c-daly/skala/firmware/opencr_reflex/README.md

# opencr_reflex

Reflex layer for prototype 0, running on the OpenCR 1.0 (Arduino-compatible, Dynamixel TTL bus, onboard IMU).

Responsibilities: arm pitch position limits, drive velocity, servo current trips, IMU tip-over cutoff,
500 ms watchdog on the serial link to the Pi, framed serial protocol. Not yet started.
