c-daly/skala/docs/concept/track_robot_concept.png

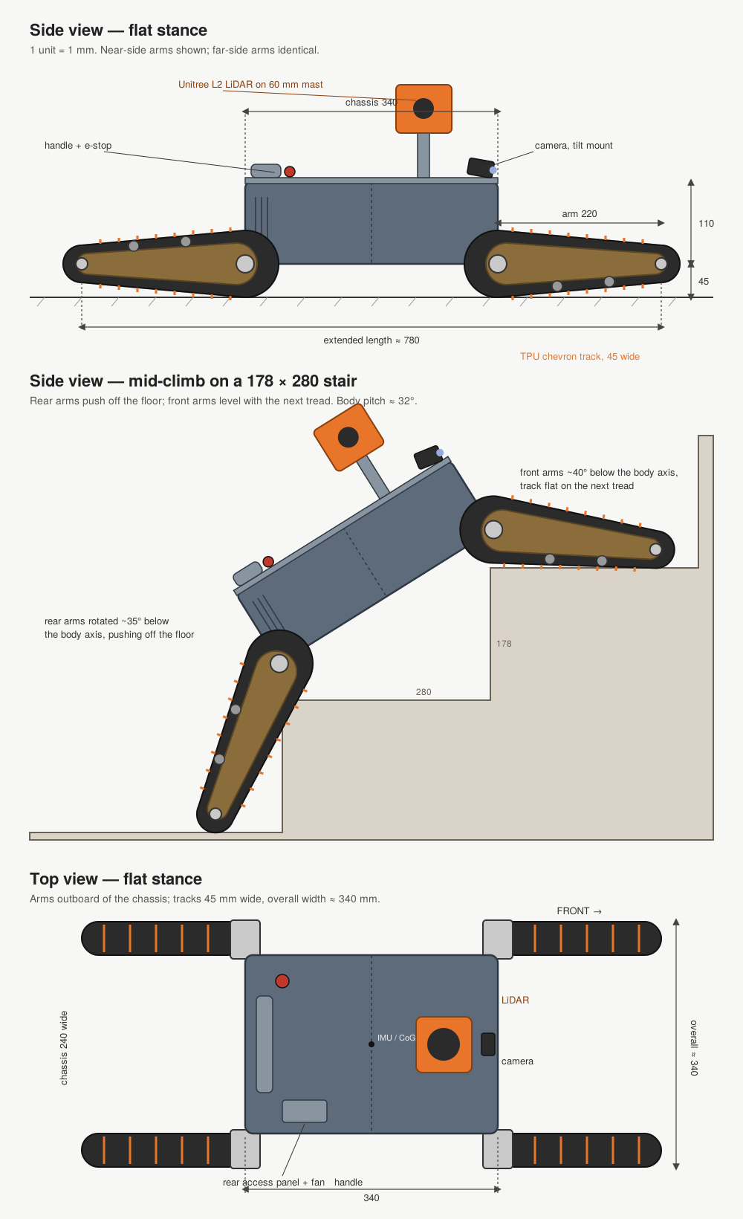
docs/concept/track_robot_concept.png
