c-daly/skala/cad/out/step/assembly_p0_4arm_pitch30.step

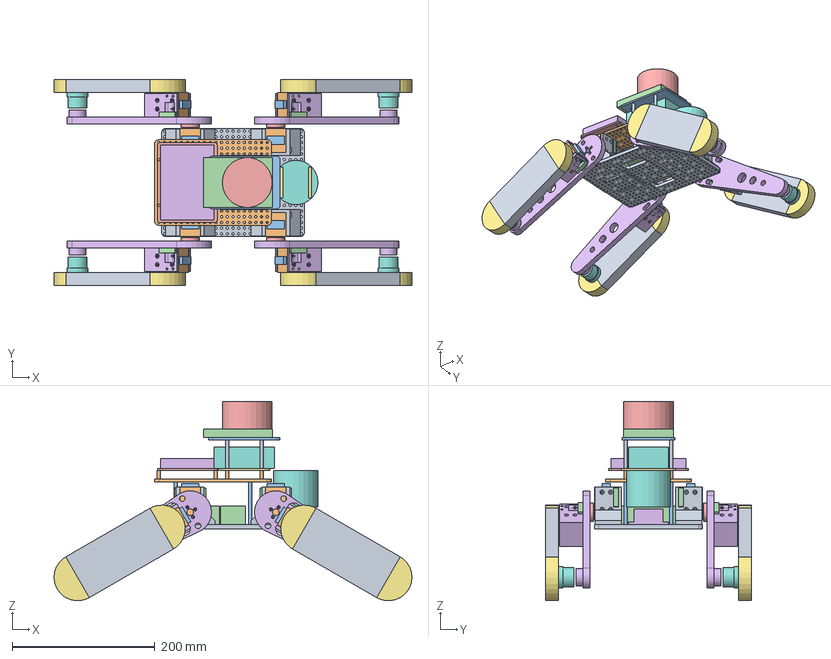
[picture p2: CAD file, 2026-10-28]
cad/out/step/assembly_p0_4arm_pitch30.step
501.7 x 288.4 x 279.5 mm
chassis_p0
deck_p0
opencr_adapter_p0
pi_adapter_p0
lidar_adapter_p0
pan_base_p0
tilt_yoke_p0
pitch_mount_p0 x 4
pivot_spacer_p0 x 4
arm_p0 x 4
tip_hub_p0 x 4
