c-daly/skala/cad/out/step/assembly_p0_pitch30.step

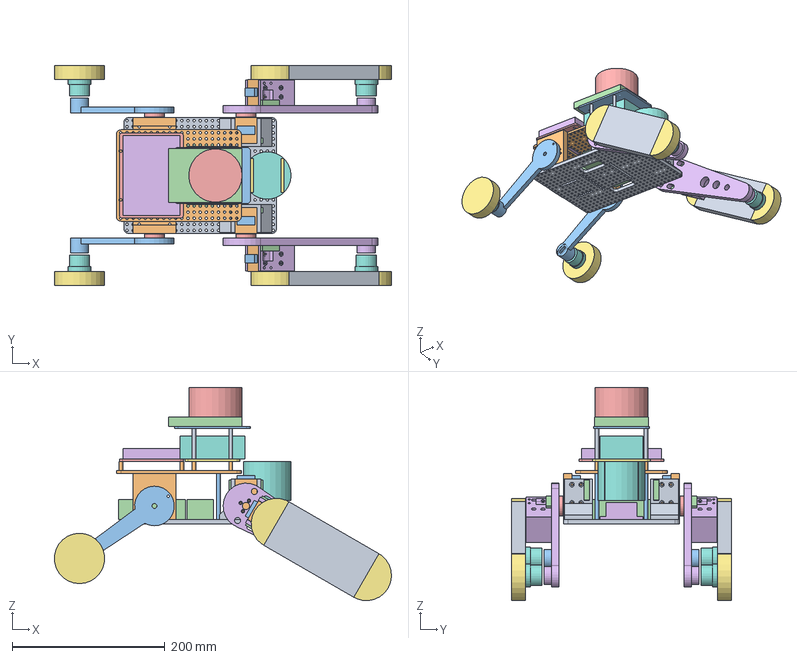
[picture p3: CAD file, 2026-10-28]
cad/out/step/assembly_p0_pitch30.step
442.0 x 288.4 x 279.5 mm
chassis_p0
deck_p0
opencr_adapter_p0
pi_adapter_p0
lidar_adapter_p0
pan_base_p0
tilt_yoke_p0
pitch_mount_p0 x 2
pivot_spacer_p0 x 4
arm_p0 x 2
tip_hub_p0 x 4
skid_bracket_p0 x 2
skid_arm_p0 x 2
