c-daly/skala/cad/out/step/assembly_p0_pitch0.step

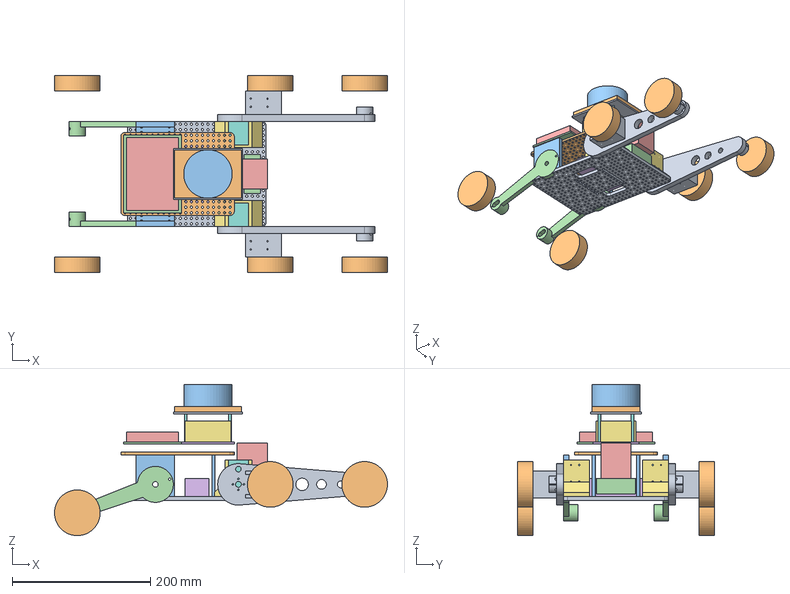
[picture p4: CAD file, 2026-10-28]
cad/out/step/assembly_p0_pitch0.step
481.0 x 284.0 x 218.5 mm
chassis_p0
deck_p0
pitch_mount_p0 x 2
arm_p0 x 2
skid_bracket_p0 x 2
skid_arm_p0 x 2
