c-daly/skala/cad/out/step/assembly_p0_4arm_pitch0.step

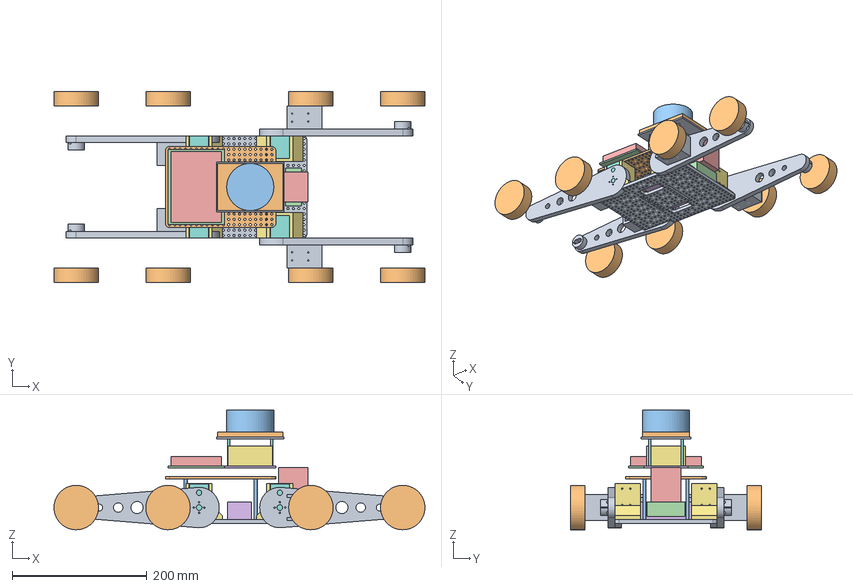
[picture p5: CAD file, 2026-10-28]
cad/out/step/assembly_p0_4arm_pitch0.step
550.6 x 284.0 x 177.4 mm
chassis_p0
deck_p0
pitch_mount_p0 x 4
arm_p0 x 4
