c-daly/skala/cad/out/step/assembly_p0_pitch45.step

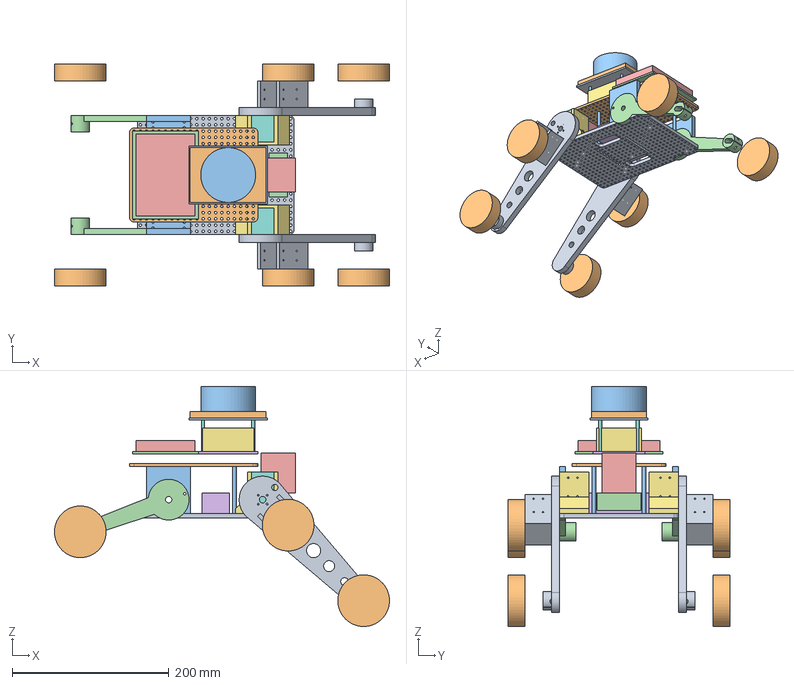
[picture p6: CAD file, 2026-10-28]
cad/out/step/assembly_p0_pitch45.step
427.6 x 284.0 x 306.4 mm
chassis_p0
deck_p0
pitch_mount_p0 x 2
arm_p0 x 2
skid_bracket_p0 x 2
skid_arm_p0 x 2
