c-daly/skala/cad/out/step/skid_bracket_p0_L.step

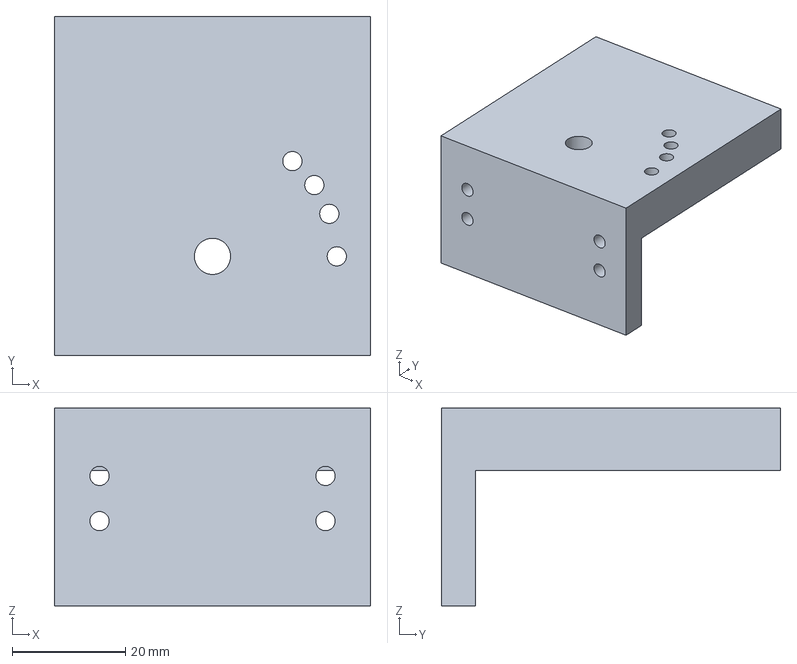
[picture p7: CAD file, 2026-10-28]
cad/out/step/skid_bracket_p0_L.step
56.0 x 60.0 x 35.0 mm
