c-daly/skala/cad/out/step/camera_cradle_p0.step

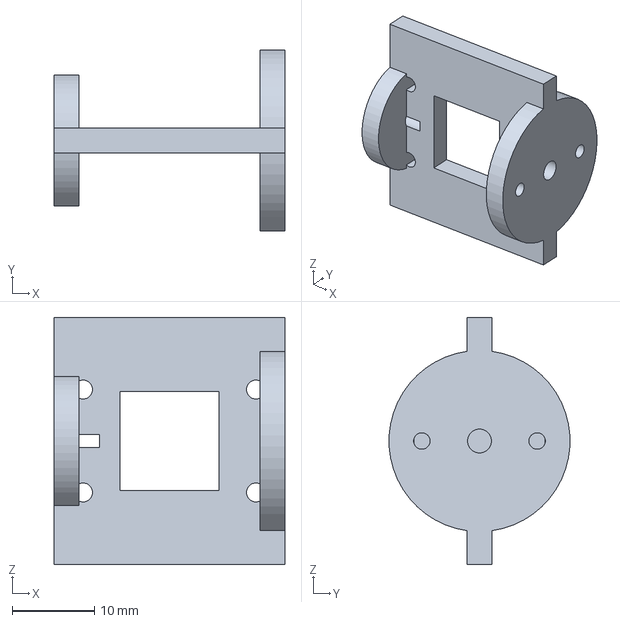
[picture p8: CAD file, 2026-10-28]
cad/out/step/camera_cradle_p0.step
28.0 x 22.0 x 30.0 mm
