c-daly/skala/cad/out/step/arm_p0.step

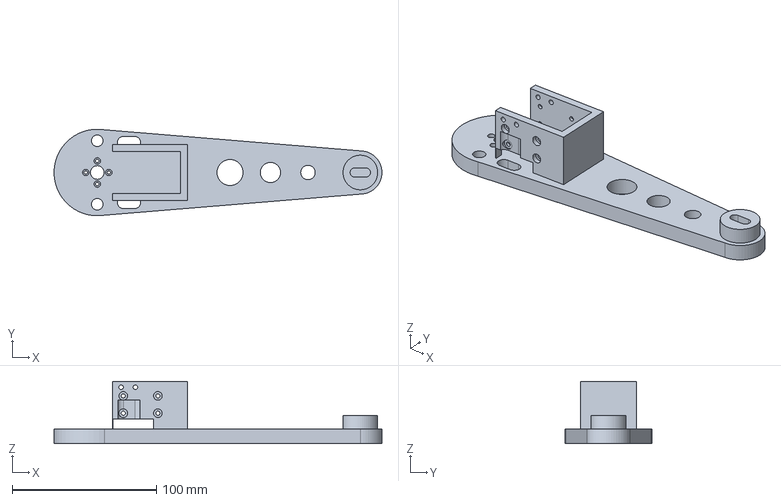
[picture p9: CAD file, 2026-10-28]
cad/out/step/arm_p0.step
227.3 x 60.0 x 43.0 mm
