c-daly/skala/cad/out/step/opencr_adapter_p0.step

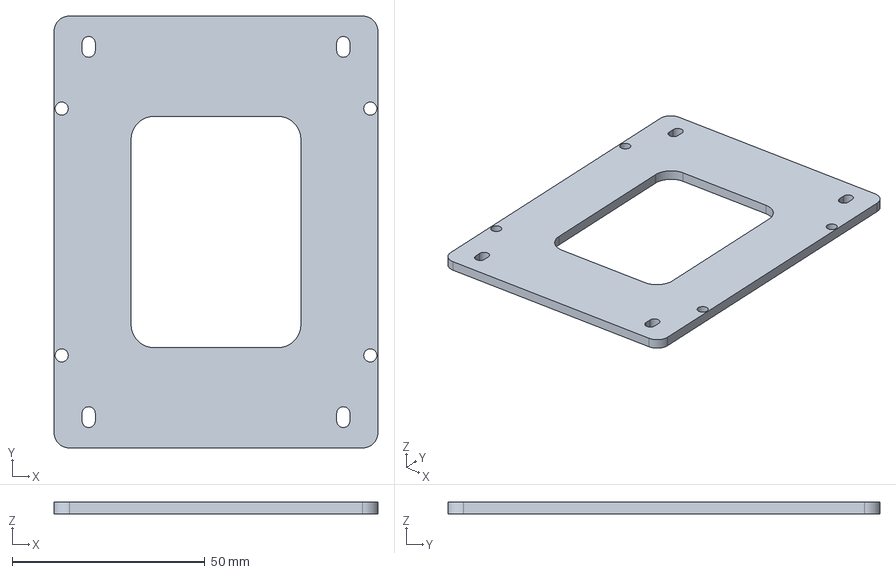
[picture p10: CAD file, 2026-10-28]
cad/out/step/opencr_adapter_p0.step
84.0 x 112.0 x 3.00 mm
