c-daly/skala/cad/out/step/coupon_p0.step

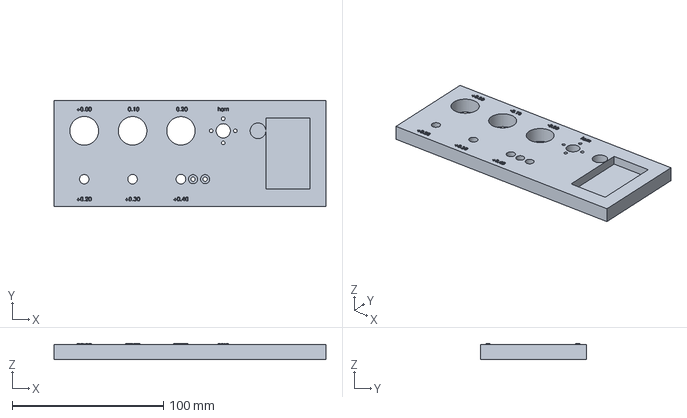
[picture p11: CAD file, 2026-10-28]
cad/out/step/coupon_p0.step
180.0 x 70.0 x 10.6 mm
