c-daly/skala/cad/out/step/pivot_spacer_p0.step

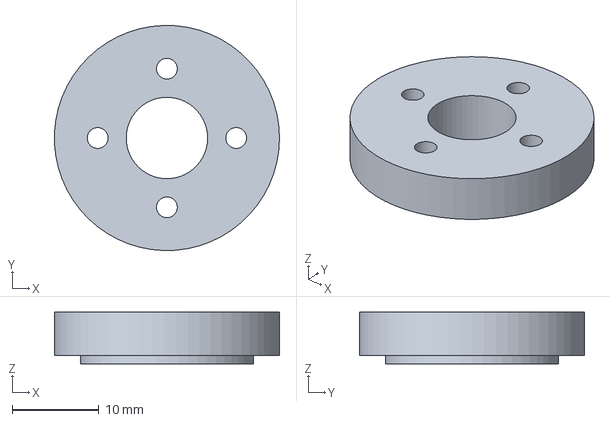
[picture p12: CAD file, 2026-10-28]
cad/out/step/pivot_spacer_p0.step
26.0 x 26.0 x 6.00 mm
