c-daly/skala/cad/out/step/pitch_mount_p0.step

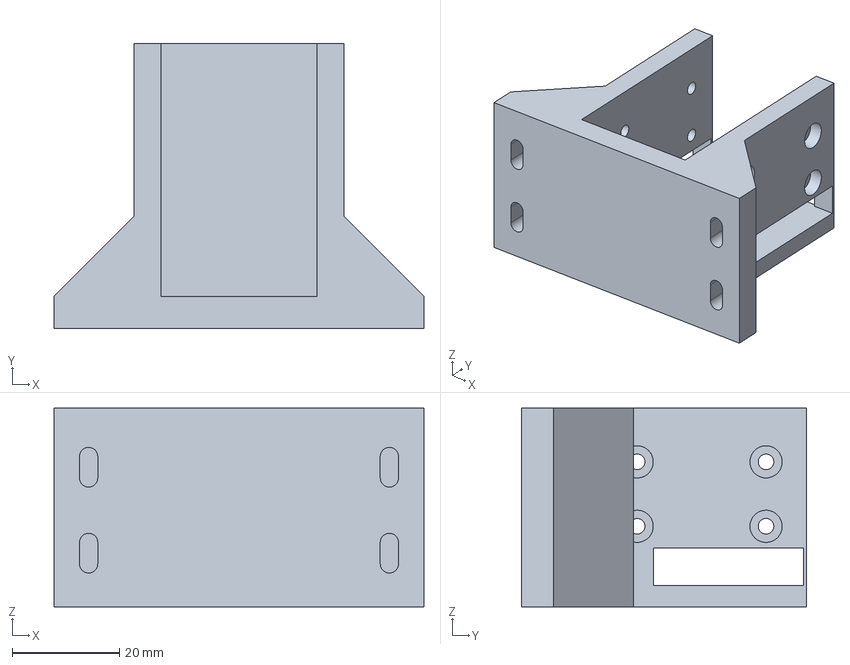
[picture p13: CAD file, 2026-10-28]
cad/out/step/pitch_mount_p0.step
68.9 x 53.1 x 37.0 mm
