c-daly/skala/cad/out/step/tilt_yoke_p0.step

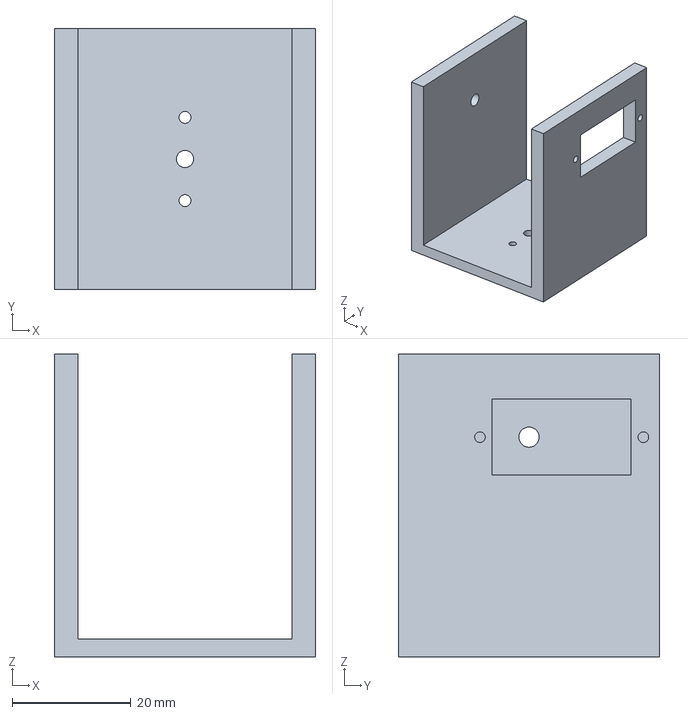
[picture p14: CAD file, 2026-10-28]
cad/out/step/tilt_yoke_p0.step
44.0 x 44.0 x 51.0 mm
