c-daly/skala/cad/out/step/lidar_adapter_p0.step

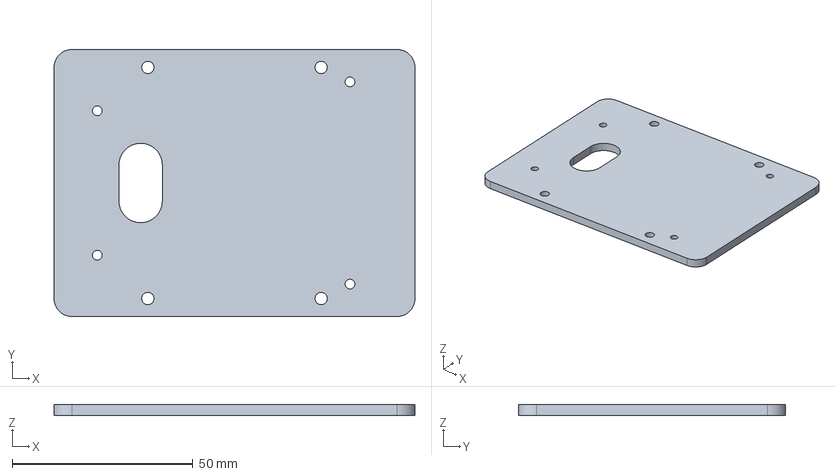
[picture p15: CAD file, 2026-10-28]
cad/out/step/lidar_adapter_p0.step
100.0 x 74.0 x 3.00 mm
