c-daly/skala/cad/out/step/pi_adapter_p0.step

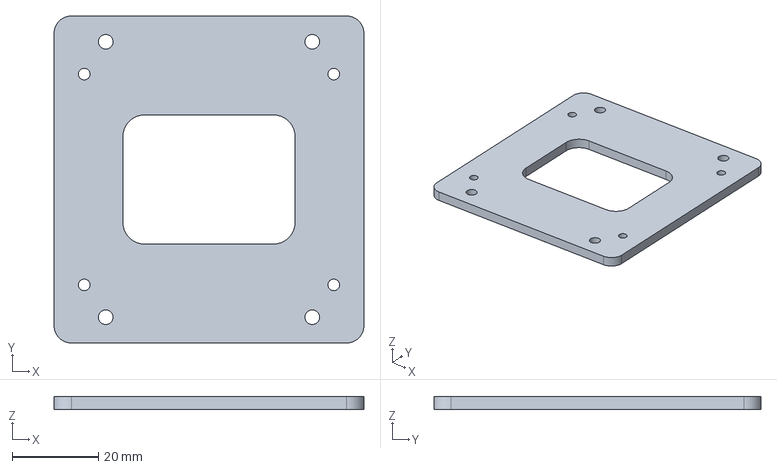
[picture p16: CAD file, 2026-10-28]
cad/out/step/pi_adapter_p0.step
72.0 x 76.0 x 3.00 mm
