c-daly/skala/cad/out/step/camera_mount_p0.step

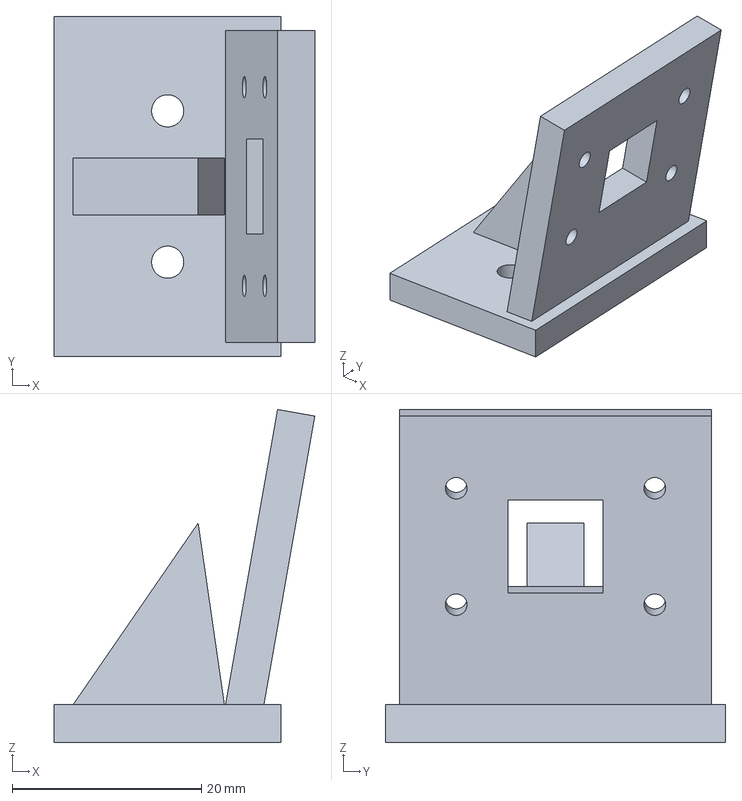
[picture p17: CAD file, 2026-10-28]
cad/out/step/camera_mount_p0.step
27.6 x 36.0 x 35.2 mm
