c-daly/skala/cad/out/step/tip_hub_p0.step

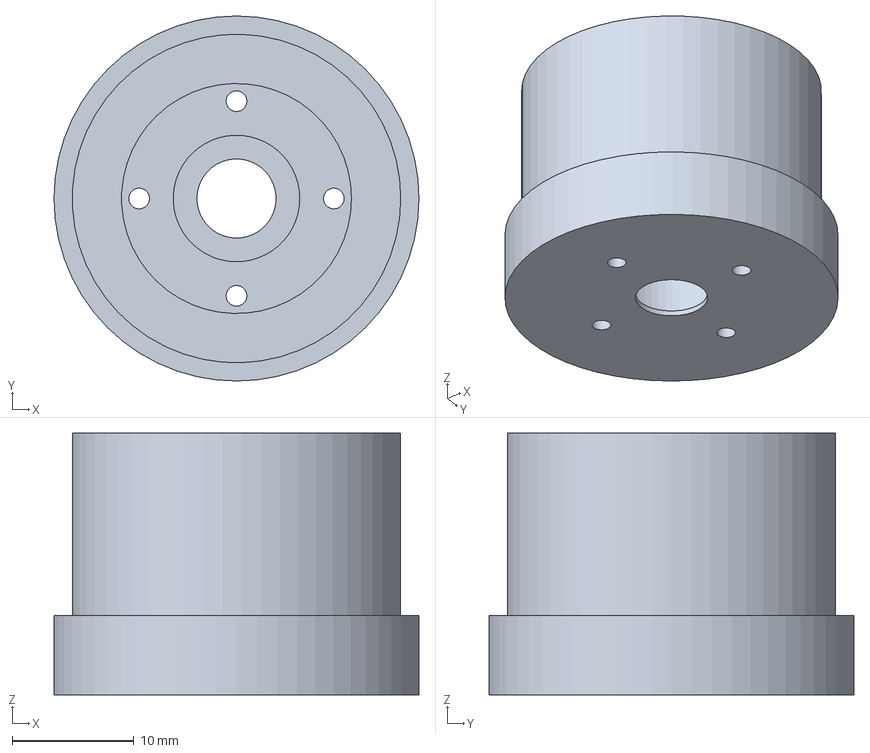
[picture p18: CAD file, 2026-10-28]
cad/out/step/tip_hub_p0.step
30.0 x 30.0 x 21.5 mm
