c-daly/skala/cad/out/step/hub_spacer_p0.step

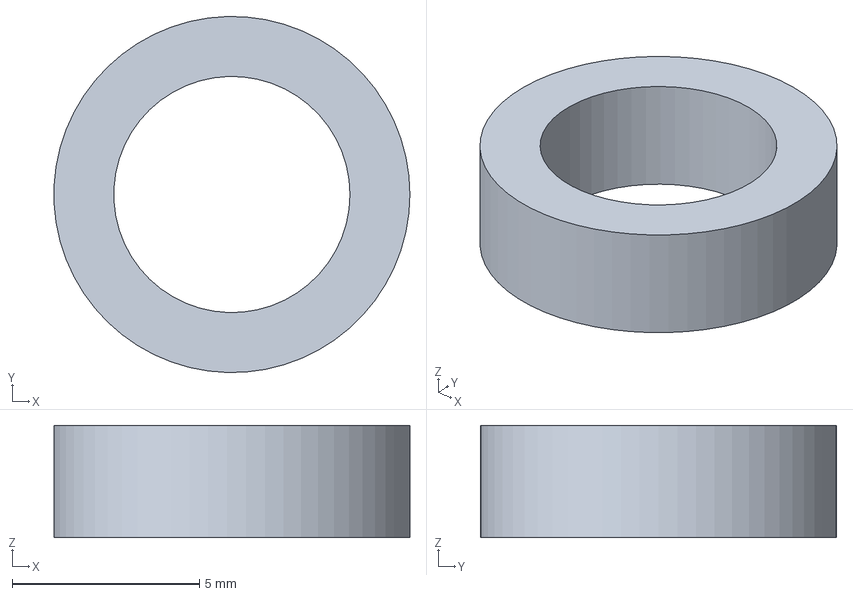
[picture p19: CAD file, 2026-10-28]
cad/out/step/hub_spacer_p0.step
9.49 x 9.50 x 3.00 mm
