c-daly/skala/cad/out/step/deck_p0.step

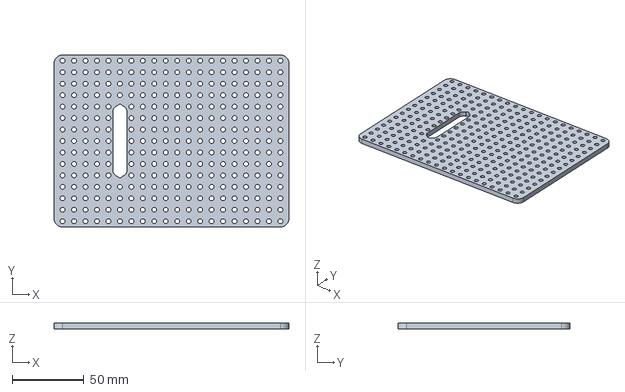
[picture p20: CAD file, 2026-10-28]
cad/out/step/deck_p0.step
164.0 x 120.0 x 4.00 mm
