c-daly/skala/cad/out/step/pan_base_p0.step

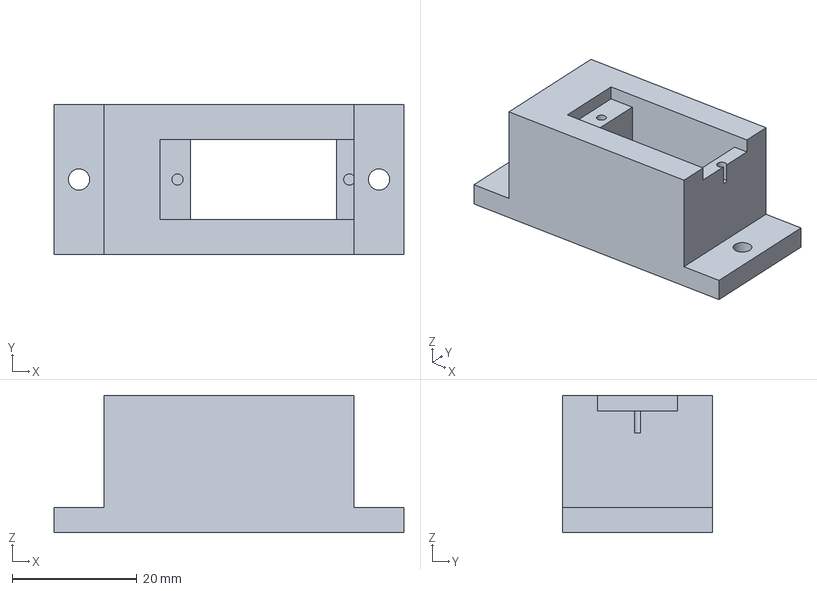
[picture p21: CAD file, 2026-10-28]
cad/out/step/pan_base_p0.step
56.0 x 24.0 x 22.0 mm
