c-daly/skala/cad/out/step/chassis_p0.step

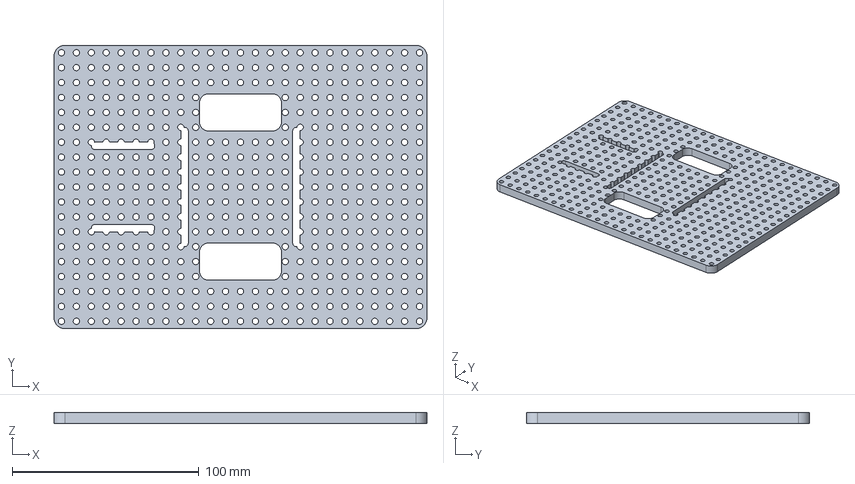
[picture p22: CAD file, 2026-10-28]
cad/out/step/chassis_p0.step
200.0 x 152.0 x 6.00 mm
