c-daly/skala/cad/out/step/skid_arm_p0.step

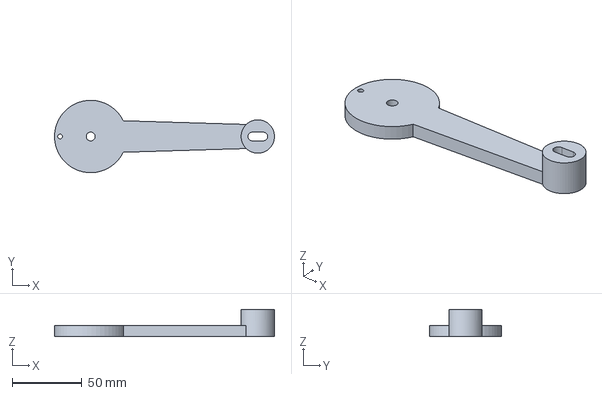
[picture p23: CAD file, 2026-10-28]
cad/out/step/skid_arm_p0.step
158.0 x 52.0 x 19.5 mm
