c-daly/skala/cad/out/step/skid_bracket_p0.step

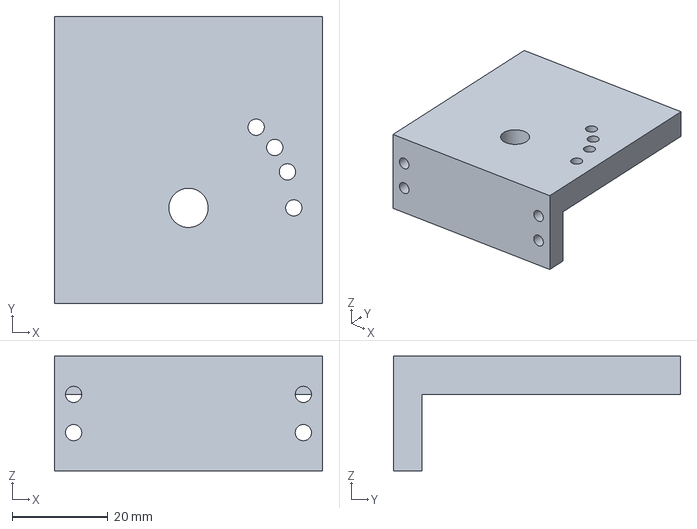
[picture p24: CAD file, 2026-10-24]
cad/out/step/skid_bracket_p0.step
56.0 x 60.0 x 24.0 mm
