c-daly/skala/(list of files, cad)

Other CAD files:
cad/out/step/skid_bracket_p0_R.step
cad/out/stl/arm_p0.stl
cad/out/stl/camera_cradle_p0.stl
cad/out/stl/camera_mount_p0.stl
cad/out/stl/chassis_p0.stl
cad/out/stl/coupon_p0.stl
cad/out/stl/deck_p0.stl
cad/out/stl/hub_spacer_p0.stl
cad/out/stl/lidar_adapter_p0.stl
cad/out/stl/opencr_adapter_p0.stl
cad/out/stl/pan_base_p0.stl
cad/out/stl/pi_adapter_p0.stl
cad/out/stl/pitch_mount_p0.stl
cad/out/stl/pivot_spacer_p0.stl
cad/out/stl/skid_arm_p0.stl
cad/out/stl/skid_bracket_p0_L.stl
cad/out/stl/skid_bracket_p0_R.stl
cad/out/stl/tilt_yoke_p0.stl
cad/out/stl/tip_hub_p0.stl
