c-daly/skala/(commit log)

2026-10-24 Initial commit: P0 arm and tip hub CAD, concept drawings, repo layout
    Claude-Session: https://claude.ai/code/session_01RJigCaMUXPZYWiUWEcpvdL
    [arm_p0.step, arm_p0.stl, tip_hub_p0.step, tip_hub_p0.stl]
2026-10-24 Add P0 tolerance coupon and chassis-side pitch servo mount; print order in manifest
    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
    [arm_p0.step, coupon_p0.step, coupon_p0.stl, pitch_mount_p0.step, pitch_mount_p0.stl, tip_hub_p0.step]
2026-10-24 P0 chassis plate, rear skids, Pi adapter, assembly check; align pitch mount feet to the 8 mm grid
    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
    [arm_p0.step, assembly_p0_pitch0.step, assembly_p0_pitch30.step, chassis_p0.step, chassis_p0.stl, coupon_p0.step, pi_adapter_p0.step, pi_adapter_p0.stl]
2026-10-27 Docs: design spec, filament guide and talos manifest note into the repo; P0 assembly guide; README index
    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
2026-10-27 Correct handedness: arms and skid arms are symmetric (no mirroring); skid bracket emitted as L/R; four-arm option in assembly script
    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
    [assembly_p0_4arm_pitch0.step, assembly_p0_4arm_pitch30.step, skid_arm_p0.step, skid_bracket_p0_L.step, skid_bracket_p0_L.stl, skid_bracket_p0_R.step, skid_bracket_p0_R.stl]
2026-10-27 P0 assembly guide rewritten for two configurations (A full / B interim) with schematic figures; upper deck part; figure generator
    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
    [arm_p0.step, assembly_p0_4arm_pitch30.step, assembly_p0_pitch30.step, chassis_p0.step, coupon_p0.step, deck_p0.step, deck_p0.stl, pi_adapter_p0.step]
2026-10-27 Add Pi Camera mount to P0; camera in guide, spec, manifest and figures
    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
    [assembly_p0_4arm_pitch30.step, assembly_p0_pitch30.step, camera_mount_p0.step, camera_mount_p0.stl]
2026-10-27 Camera on a two-servo pan/tilt head (MG90S on OpenCR PWM): parts, guide, figure 7, manifest actuators; fixed mount kept as fallback
    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
    [assembly_p0_4arm_pitch30.step, assembly_p0_pitch30.step, camera_cradle_p0.step, camera_cradle_p0.stl, pan_base_p0.step, pan_base_p0.stl, tilt_yoke_p0.step, tilt_yoke_p0.stl]
2026-10-27 assembly and spec docs
    [arm_p0.step, chassis_p0.step, coupon_p0.step, coupon_p0.stl, pi_adapter_p0.step, pitch_mount_p0.step, skid_arm_p0.step, skid_bracket_p0_L.step]
2026-10-28 P0 layout fix: larger deck, LiDAR on standoffs above the Pi, camera head on the chassis; power budget with split supplies (LiPo motors / power bank compute)
    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
    [arm_p0.step, assembly_p0_4arm_pitch30.step, assembly_p0_pitch30.step, camera_cradle_p0.step, camera_mount_p0.step, chassis_p0.step, coupon_p0.step, deck_p0.step]
2026-10-28 Make every mounting position explicit: PLACE/STACK tables in params, dimensioned placement figures (chassis, deck, stack-up, pivot axis), OpenCR and LiDAR adapters, skid/Pi holes moved onto the grid
    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
    [arm_p0.step, assembly_p0_4arm_pitch30.step, assembly_p0_pitch30.step, camera_cradle_p0.step, camera_mount_p0.step, chassis_p0.step, coupon_p0.step, coupon_p0.stl]
2026-10-28 Tip boss shortened to 21 mm and split for the clamp (hub had no room); shaft collar + washer retain the hub; Figure 11 arm section; guide explains the idler
    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
    [arm_p0.step, arm_p0.stl, camera_cradle_p0.step, camera_mount_p0.step, chassis_p0.step, coupon_p0.step, deck_p0.step, lidar_adapter_p0.step]
2026-10-28 Fit the XL430 from Robotis's STEP model: housing, pitch mount, cable routing
    The drive housing and pitch mount were built on a guessed servo: screws
    at ±18 along the long side, output axis in the middle, cable slot where
    no connector is. From the Robotis xl430 STEP: body 28.5 x 46.5 x 34,
    output axis 11.25 from the horn end, M2 case taps at 4/28 from the axis
    and ±6 about mid-depth, connectors on the back end face.
    - params: XL430_HORN_OFF, XL430_SIDE_HOLES_L/D, XL430_BACK_HOLES; drop
    XL430_SIDE_HOLES_Y; DRIVE_X 30 -> 46; CABLE_HOLE_*; STACK pivot_axis
    - arm_p0: servo lies along the arm, back (connector) end toward the
    pivot, housing open that end; screws at the real taps; Ø8 lead ho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
    [arm_p0.step, arm_p0.stl, assembly_p0_4arm_pitch0.step, assembly_p0_4arm_pitch30.step, assembly_p0_pitch0.step, assembly_p0_pitch30.step, assembly_p0_pitch45.step, camera_cradle_p0.step]
2026-10-28 Full design audit: tip hub, screws, horn relief, spacers, placements, power bay, check script
    Walked the whole P0 design as an assembler would, then built a numeric
    check (cad/check_p0.py) that places every part and hardware envelope at
    six poses in both configurations and tests interference, hole alignment
    to the grids, clearances, and mass / CoG / tip-back from params.MASS.
    Everything below was found by that walk and is fixed here; the check
    ends with 0 failures.
    Fit and fasteners
    - Tip hub: the front 608 seat was a closed cavity (flange one side,
    web the other) - unbuildable. Redesigned: M6 x 50 hex bolt as the
    axle, hex head captive in the hub flange, two 626 bearings in a
    through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
    [arm_p0.step, arm_p0.stl, assembly_p0_4arm_pitch30.step, assembly_p0_pitch30.step, camera_cradle_p0.step, camera_mount_p0.step, chassis_p0.step, chassis_p0.stl]
2026-10-28 Replace "measure it" with the makers' numbers
    Chris asked why the guide was telling him to measure known quantities.
    It shouldn't have been. Every bought-part dimension is now traced to a
    primary source in params.py and the VERIFY flags are gone:
    - XL430 horn: 4 x M2 on PCD 16, confirmed from the TB3 wheel mesh in
    Robotis's own TurtleBot3 URDF (four Ø2.1 holes at r = 8.00); nothing
    stands at the horn centre (Ø9 recess in the STEP; the wheel has a Ø7 bore)
    - TB3 wheel: Ø66 x 18.2 (not 22), Ø7 centre bore, 2 mm hub plate (same mesh);
    66 is also the rolling diameter with the caterpillar on, per the Tank
    firmware's WHEEL_RADIUS 0.033
    - ICT-01: 6 mm pitch per Robotis Japan; 40 per p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
    [arm_p0.step, arm_p0.stl, assembly_p0_4arm_pitch30.step, assembly_p0_pitch30.step, camera_cradle_p0.step, camera_mount_p0.step, chassis_p0.step, coupon_p0.step]
2026-10-28 Open the servo cable exits; make the check fail when they are blocked
    The XL430's wires come out in two places: the two connector windows in
    the back END face (7.5 x 2.5, at W = +/-8; the plug seats ~9 mm inside)
    and a SIDE window in each narrow face against the idler surface, 8-34 mm
    from the output axis toward the back. Geometry from the detailed XL430
    in Robotis's TurtleBot3 Burger mesh, cross-checked with the dummy STEP.
    Both the arm housing and the pitch mount had 5 mm of solid wall over the
    side windows, and the mount's end windows pointed at the deck. Fixed:
    - arm_p0: side walls cut away x 11-35, 7 mm up from the plate (both
    sides); a 16 x 8 slot through the plate under each cut a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
    [arm_p0.step, arm_p0.stl, assembly_p0_4arm_pitch30.step, assembly_p0_pitch30.step, camera_cradle_p0.step, camera_mount_p0.step, chassis_p0.step, coupon_p0.step]
